SrFatCat/mysLegWarmer/image/pcb.png

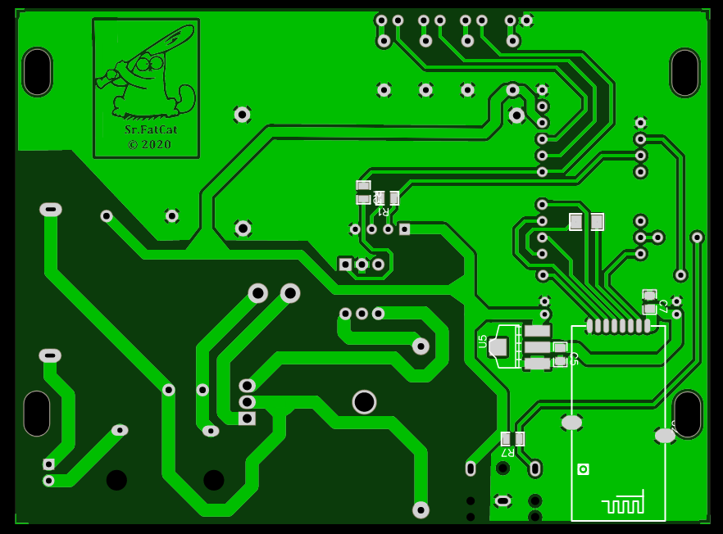
image/pcb.png
