SrFatCat/mysLegWarmer/(commit log)

2020-09-29 Начальная версия
2020-09-29 Добавил README и картинки
2020-09-30 Добавил TODO
2020-10-01 Добавил в TODO яркость светодиода
2020-10-05 Увелич. время HB, подтвержд. парам., свет RF ночью
