SrFatCat/mysLegWarmer/image/interior.jpg

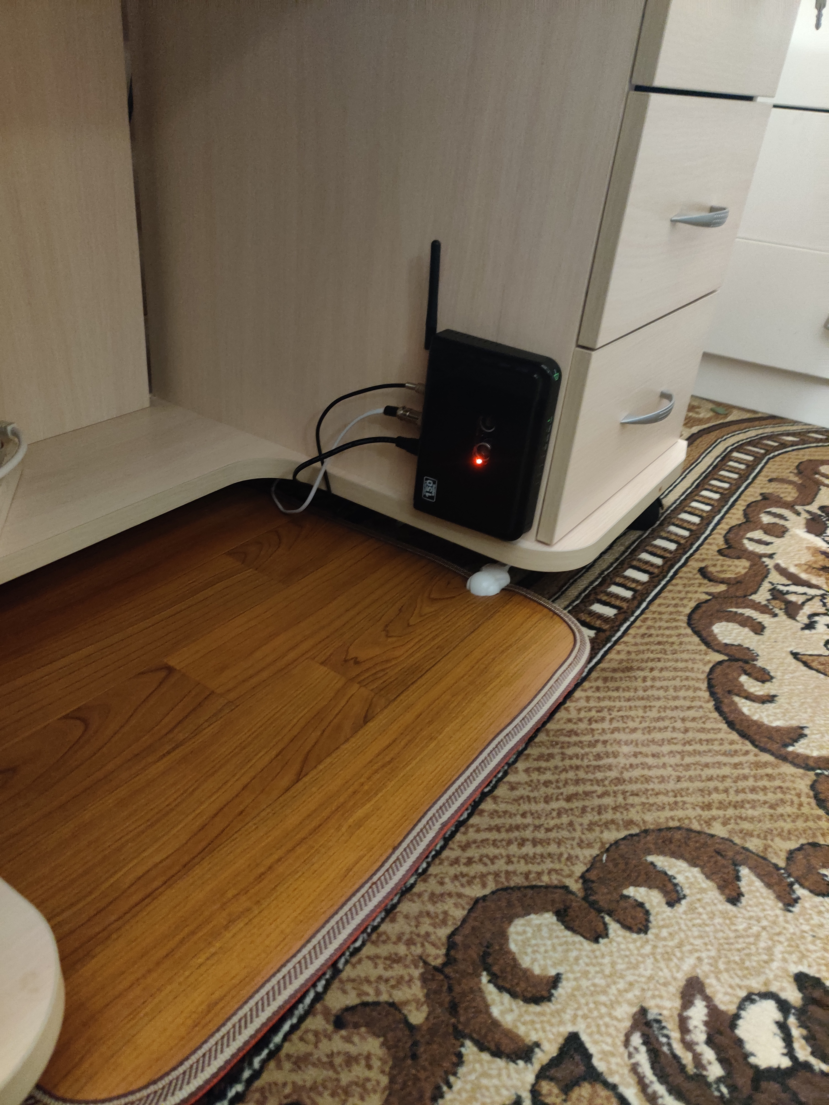
[picture p6: image/interior.jpg]
image/interior.jpg
